Th3o4oR/Maggy/Maggy.kicad_pcb

## KiCad design Maggy.kicad_pcb (2026-10-21)

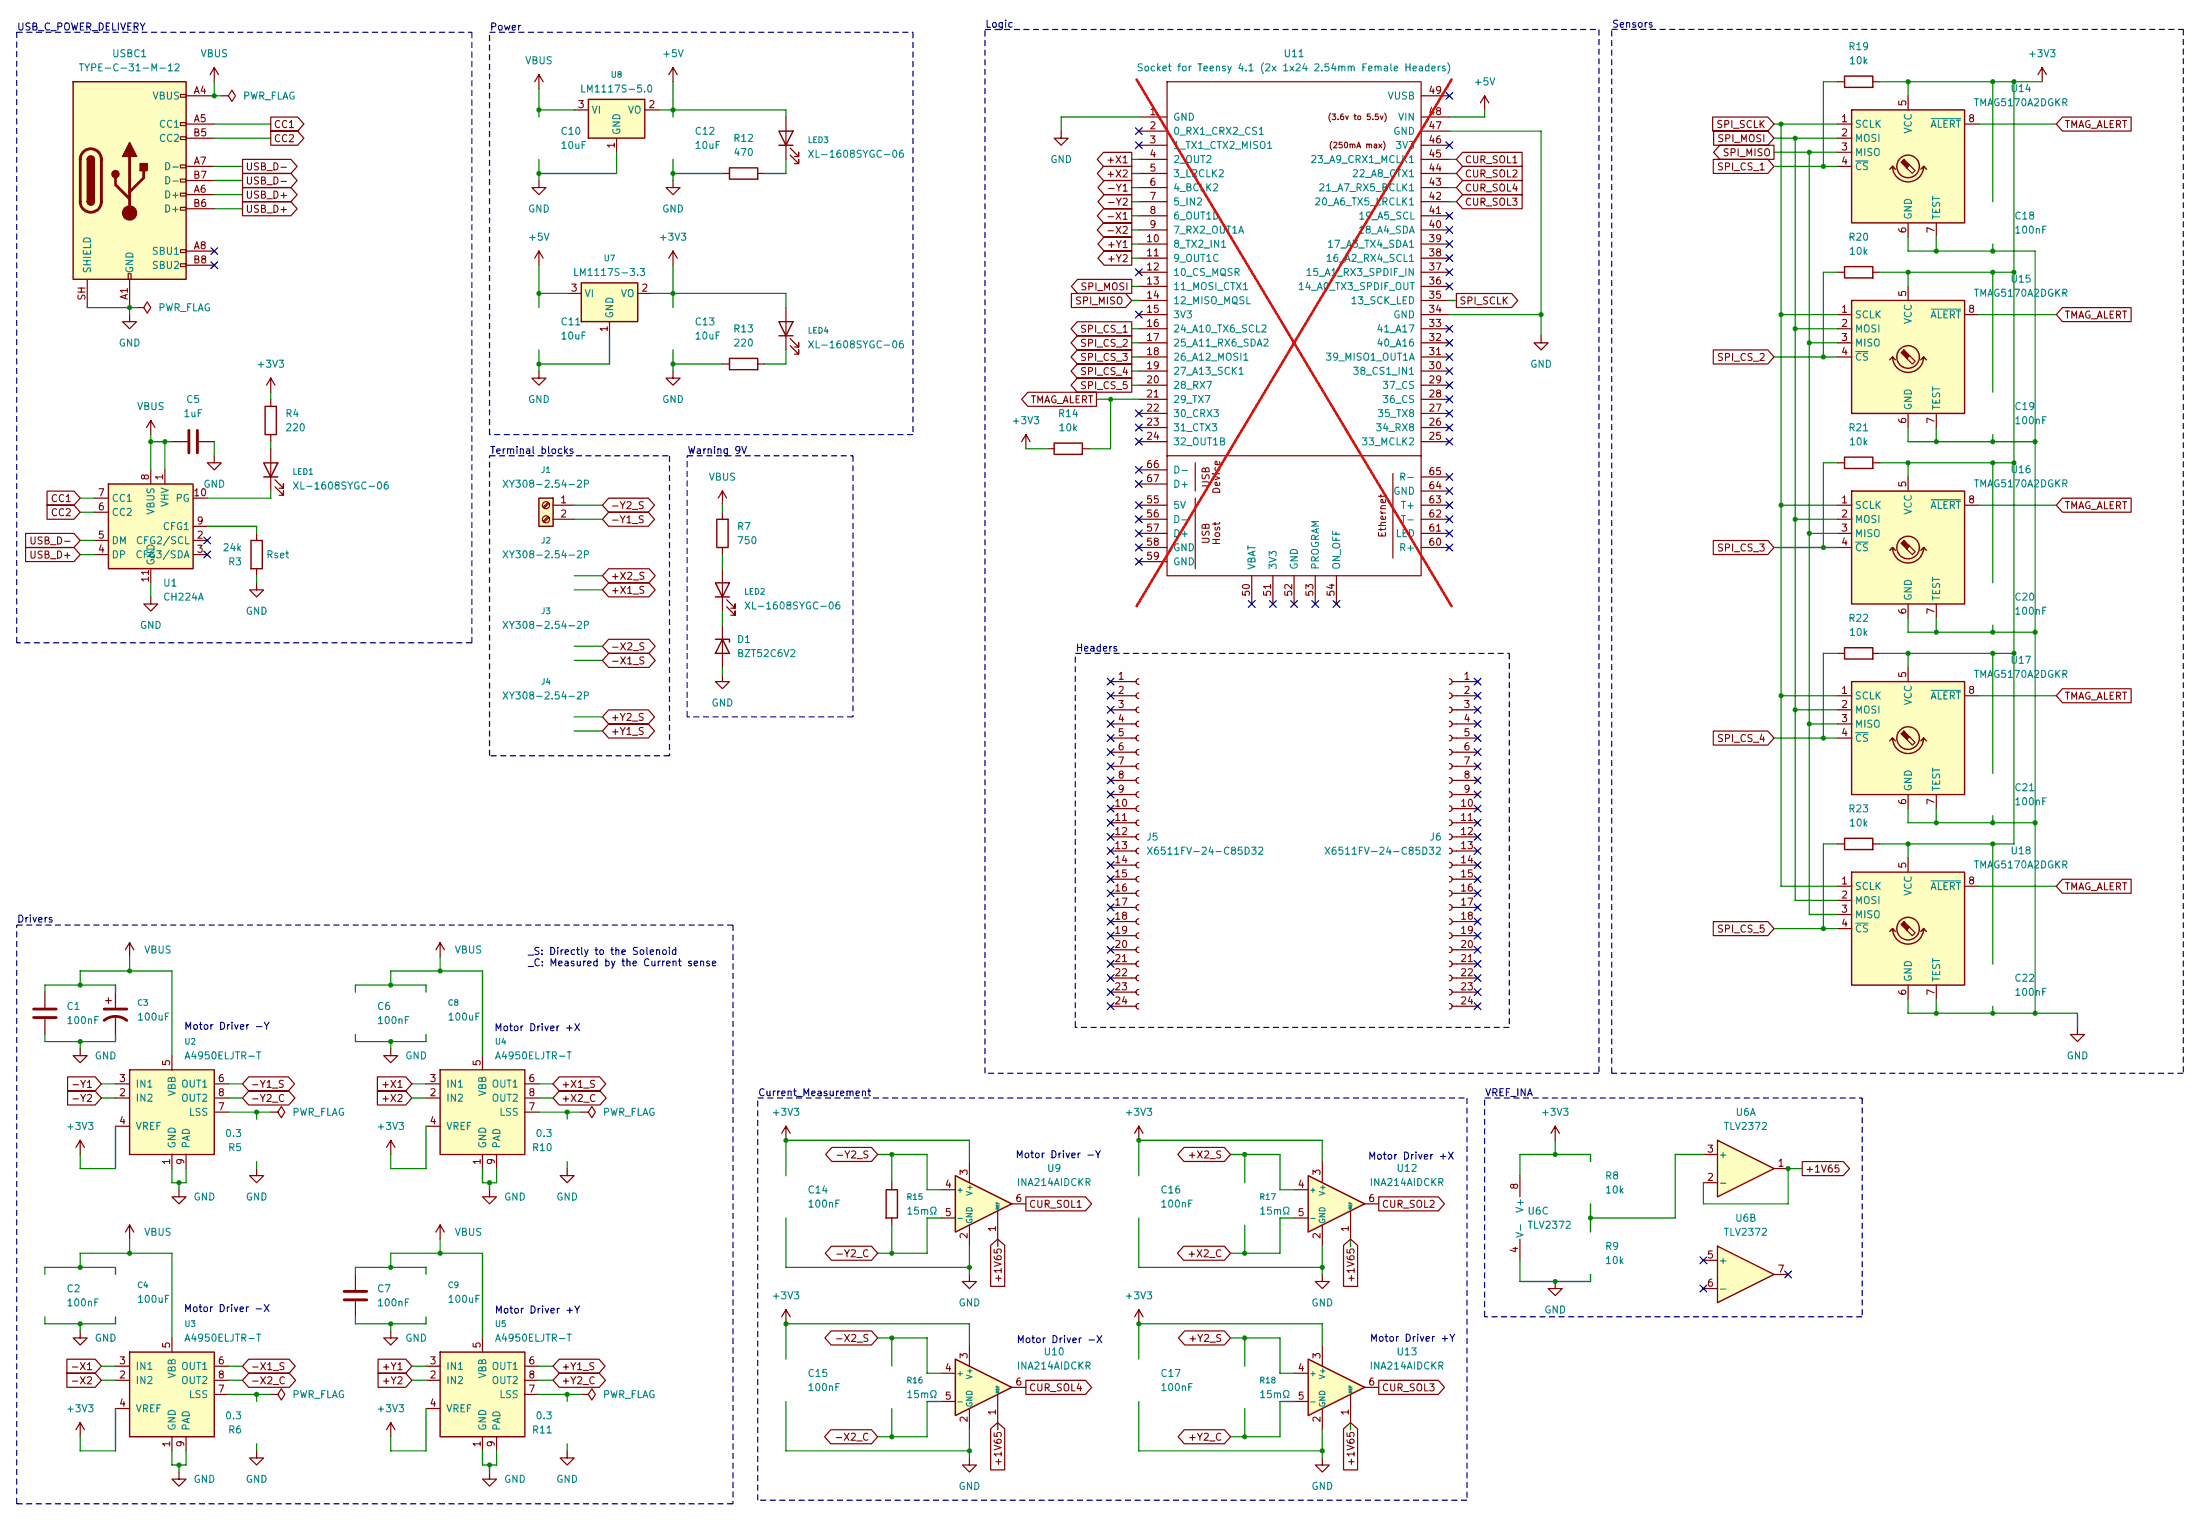
[picture p1: schematic Maggy.kicad_sch, Maggy Main Board]

Parts:
C1, C2, C6, C7, C14, C15, C16, C17, C18, C19, C20, C21, C22: 100nF; C_0603_1608Metric; LCSC C14663
C3, C4, C8, C9: 100uF; C_Elec_6.3x7.7; Manufacturer Part RST100UF35V009; LCSC Part Name 100uF ±20% 35V
C5: 1uF; C_0805_2012Metric; LCSC C28323
C10, C11, C12, C13: 10uF; C_0805_2012Metric; LCSC C15850
D1: BZT52C6V2; D_SOD-123; Manufacturer Part BZT52C6V2; LCSC Part Name BZT52C6V2
J1, J2, J3, J4: XY308-2.54-2P; TerminalBlock_Xinya_XY308-2.54-2P_1x02_P2.54mm_Horizontal; Manufacturer Part XY308-2.54-2P; LCSC Part Name 2.54mm 1x2P 排数:1 每排P数:2 直插
J5, J6: X6511FV-24-C85D32; PinHeader_1x24_P2.54mm_Vertical_NO_PADS; Manufacturer Part X6511FV-24-C85D32; LCSC C2883741
LED1: XL-1608SYGC-06; LED_0603_1608Metric; Manufacturer Part XL-1608SYGC-06; LCSC C965805
LED2, LED3, LED4: XL-1608SYGC-06; LED_0603_1608Metric; Manufacturer Part XL-1608SYGC-06; LCSC Part Name XL-1608SYGC-06
R3: 24k; R_0805_2012Metric; LCSC C17575
R4, R13: 220; R_0805_2012Metric; LCSC C17557
R5, R6, R10, R11: 0.3; R_1206_3216Metric; LCSC C59882
R7: 750; R_0805_2012Metric; LCSC C17818
R8, R9, R14, R19, R20, R21, R22, R23: 10k; R_0805_2012Metric; LCSC C17414
R12: 470; R_0805_2012Metric; LCSC C17710
R15, R16, R17, R18: 15mΩ; R_1206_3216Metric; Manufacturer Part 1206W3F150MT5E; LCSC Part Name RES 15mΩ ±1% 333mW 1206
U1: CH224A; SSOP-10-1EP_3.9x4.9mm_P1mm_EP2.1x3.3mm_ThermalVias; LCSC C42459160
U2, U3, U4, U5: A4950ELJTR-T; SOIC-8-1EP_3.9x4.9mm_P1.27mm_EP2.41x3.3mm_ThermalVias; Manufacturer Part A4950ELJTR-T; LCSC Part Name A4950ELJTR-T
U6: TLV2372; SOIC-8_3.9x4.9mm_P1.27mm; Manufacturer Part TLV2372IDR; LCSC Part Name TLV2372IDR
U7: LM1117S-3.3; SOT-223-3_TabPin2; Manufacturer Part LM1117S-3.3; LCSC Part Name 输入12V 输出3.3V 1A
U8: LM1117S-5.0; SOT-223-3_TabPin2; Manufacturer Part LM1117S-5.0; LCSC Part Name 输入12V 输出5V 1A
U9, U10, U12, U13: INA214AIDCKR; SOT-363_SC-70-6; Manufacturer Part INA214AIDCKR; LCSC Part Name INA214AIDCKR
U11: Socket for Teensy 4.1 (2x 1x24 2.54mm Female Head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; Teensy41_Socket_Only; not fitted
U14, U15, U16, U17, U18: TMAG5170A2DGKR; TMAG5170_Origin_Shifted_VSSOP-8_3x3mm_P0.65mm; LCSC C3716101
USBC1: TYPE-C-31-M-12; USB_C_Receptacle_HRO_TYPE-C-31-M-12; LCSC C165948

Connections:
+1V65: U6.1, U6.2 (-), U9.1 (REF), U10.1 (REF), U12.1 (REF), U13.1 (REF); also elsewhere on the board
+3V3: C13.2, C14.1, C15.1, C16.1, C17.1, C18.1, C19.1, C20.1, C21.1, C22.1, LED4.2 (A), R4.2, R8.2, R14.1, R19.2, R20.2, R21.2, R22.2, R23.2, U2.4 (VREF), U3.4 (VREF), U4.4 (VREF), U5.4 (VREF), U6.8 (V+), U7.2 (VO), U9.3 (V+), U10.3 (V+), U12.3 (V+), U13.3 (V+), U14.5 (VCC), U15.5 (VCC), U16.5 (VCC), U17.5 (VCC), U18.5 (VCC); also elsewhere on the board
+5V: C11.2, C12.2, LED3.2 (A), U7.3 (VI), U8.2 (VO), U11.48 (VIN); also elsewhere on the board
+X1: U4.3 (IN1), U11.4 (2_OUT2)
+X1_S: J2.2, U4.6 (OUT1)
+X2: U4.2 (IN2), U11.5 (3_LRCLK2)
+X2_C: R17.2, U4.8 (OUT2), U12.5 (-)
+X2_S: J2.1, R17.1, U12.4 (+)
+Y1: U5.3 (IN1), U11.10 (8_TX2_IN1)
+Y1_S: J4.2, U5.6 (OUT1)
+Y2: U5.2 (IN2), U11.11 (9_OUT1C)
+Y2_C: R18.2, U5.8 (OUT2), U13.5 (-)
+Y2_S: J4.1, R18.1, U13.4 (+)
-X1: U3.3 (IN1), U11.8 (6_OUT1D)
-X1_S: J3.2, U3.6 (OUT1)
-X2: U3.2 (IN2), U11.9 (7_RX2_OUT1A)
-X2_C: R16.2, U3.8 (OUT2), U10.5 (-)
-X2_S: J3.1, R16.1, U10.4 (+)
-Y1: U2.3 (IN1), U11.6 (4_BCLK2)
-Y1_S: J1.2, U2.6 (OUT1)
-Y2: U2.2 (IN2), U11.7 (5_IN2)
-Y2_C: R15.2, U2.8 (OUT2), U9.5 (-)
-Y2_S: J1.1, R15.1, U9.4 (+)
CC1: U1.7 (CC1), USBC1.A5 (CC1)
CC2: U1.6 (CC2), USBC1.B5 (CC2)
CUR_SOL1: U9.6, U11.45 (23_A9_CRX1_MCLK1)
CUR_SOL2: U11.44 (22_A8_CTX1), U12.6
CUR_SOL3: U11.42 (20_A6_TX5_LRCLK1), U13.6
CUR_SOL4: U10.6, U11.43 (21_A7_RX5_BCLK1)
GND: C1.1, C2.1, C3.2, C4.2, C5.1, C6.1, C7.1, C8.2, C9.2, C10.1, C11.1, C12.1, C13.1, C14.2, C15.2, C16.2, C17.2, C18.2, C19.2, C20.2, C21.2, C22.2, D1.2 (A), R3.2, R5.1, R6.1, R9.1, R10.1, R11.1, R12.1, R13.1, U1.11 (GND), U2.1 (GND), U2.9 (PAD), U3.1 (GND), U3.9 (PAD), U4.1 (GND), U4.9 (PAD), U5.1 (GND), U5.9 (PAD), U6.4 (V-), U7.1 (GND), U8.1 (GND), U9.2 (GND), U10.2 (GND), U11.1 (GND), U11.34 (GND), U11.47 (GND), U12.2 (GND), U13.2 (GND), U14.6 (GND), U14.7 (TEST), U15.6 (GND), U15.7 (TEST), U16.6 (GND), U16.7 (TEST), U17.6 (GND), U17.7 (TEST), U18.6 (GND), U18.7 (TEST), USBC1.A1 (GND), USBC1.A12 (GND), USBC1.B1 (GND), USBC1.B12 (GND), USBC1.SH (SHIELD)
unnamed: D1.1 (K), LED2.1 (K)
unnamed: LED1.2 (A), R4.1
unnamed: LED1.1 (K), U1.10 (PG)
unnamed: LED2.2 (A), R7.1
unnamed: LED3.1 (K), R12.2
unnamed: LED4.1 (K), R13.2
unnamed: R3.1, U1.9 (CFG1)
unnamed: R5.2, U2.7 (LSS)
unnamed: R6.2, U3.7 (LSS)
unnamed: R10.2, U4.7 (LSS)
unnamed: R11.2, U5.7 (LSS)
unnamed: R8.1, R9.2, U6.3 (+)
SPI_CS_1: R19.1, U11.16 (24_A10_TX6_SCL2), U14.4 (~CS)
SPI_CS_2: R20.1, U11.17 (25_A11_RX6_SDA2), U15.4 (~CS)
SPI_CS_3: R21.1, U11.18 (26_A12_MOSI1), U16.4 (~CS)
SPI_CS_4: R22.1, U11.19 (27_A13_SCK1), U17.4 (~CS)
SPI_CS_5: R23.1, U11.20 (28_RX7), U18.4 (~CS)
SPI_MISO: U11.14 (12_MISO_MQSL), U14.3 (MISO), U15.3 (MISO), U16.3 (MISO), U17.3 (MISO), U18.3 (MISO); also elsewhere on the board
SPI_MOSI: U11.13 (11_MOSI_CTX1), U14.2 (MOSI), U15.2 (MOSI), U16.2 (MOSI), U17.2 (MOSI), U18.2 (MOSI); also elsewhere on the board
SPI_SCLK: U11.35 (13_SCK_LED), U14.1 (SCLK), U15.1 (SCLK), U16.1 (SCLK), U17.1 (SCLK), U18.1 (SCLK); also elsewhere on the board
TMAG_ALERT: R14.2, U11.21 (29_TX7), U14.8 (~ALERT), U15.8 (~ALERT), U16.8 (~ALERT), U17.8 (~ALERT), U18.8 (~ALERT)
USB_D+: U1.4 (DP), USBC1.A6 (D+), USBC1.B6 (D+)
USB_D-: U1.5 (DM), USBC1.A7 (D-), USBC1.B7 (D-)
VBUS: C1.2, C2.2, C3.1, C4.1, C5.2, C6.2, C7.2, C8.1, C9.1, C10.2, R7.2, U1.1 (VHV), U1.8 (VBUS), U2.5 (VBB), U3.5 (VBB), U4.5 (VBB), U5.5 (VBB), U8.3 (VI), USBC1.A4 (VBUS), USBC1.A9 (VBUS), USBC1.B4 (VBUS), USBC1.B9 (VBUS); also elsewhere on the board

Notes on the sheet:
Terminal blocks
Motor Driver +X
USB_C_POWER_DELIVERY
Warning 9V
Motor Driver -X
Sensors
Motor Driver +Y
Headers
Logic
Motor Driver -Y
VREF_INA
Power
Current_Measurement
_S: Directly to the Solenoid _C: Measured by the Current sense
Drivers

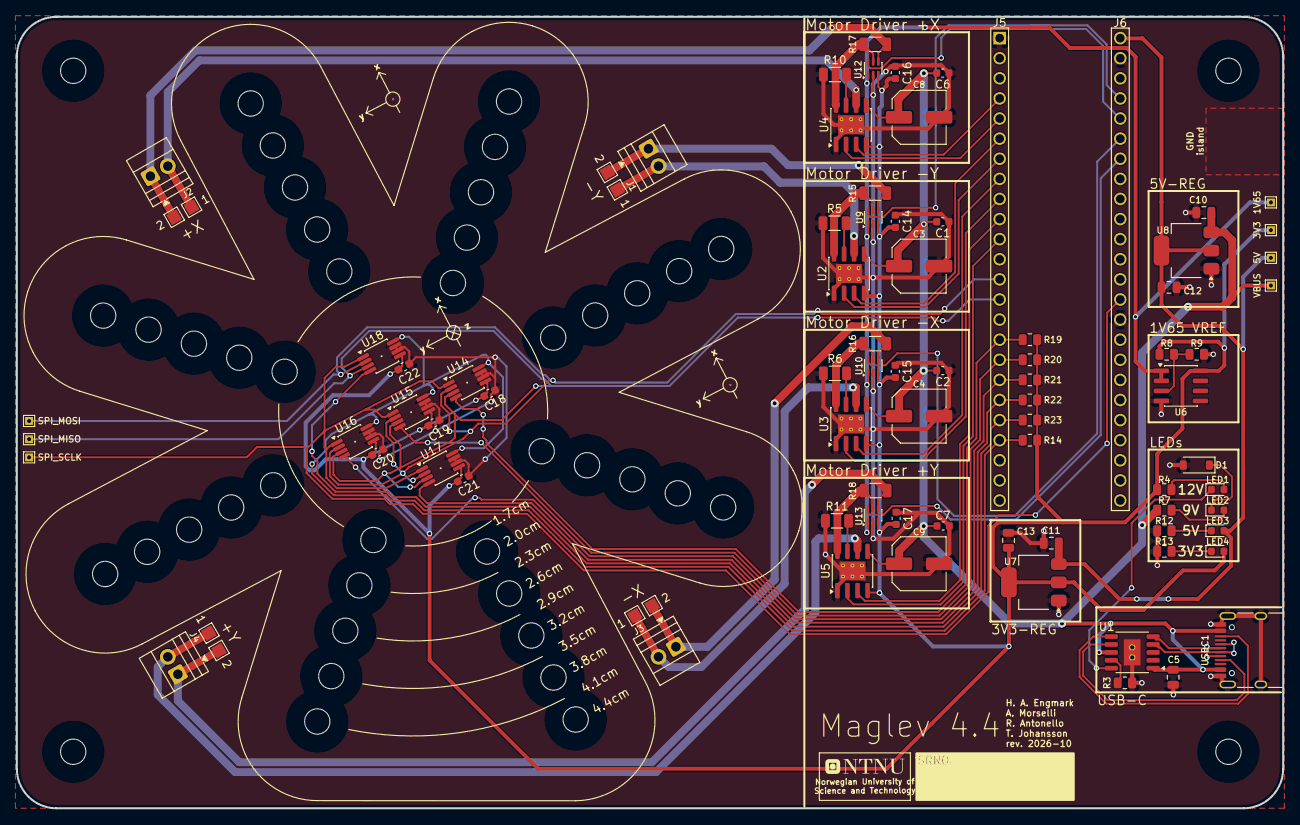
[picture p2: board Maggy.kicad_pcb from above]

Board: 2 copper layers, 160.0 x 100.0 mm, 80 parts (0 on the bottom side), 54 nets.

Other parts of the board:
1V65, 3V3, 5V: TestPoint_THTPad_1.0x1.0mm_Drill0.5mm
SPI_MISO: TestPoint_THTPad_1.0x1.0mm_Drill0.5mm
SPI_MOSI: TestPoint_THTPad_1.0x1.0mm_Drill0.5mm
SPI_SCLK: TestPoint_THTPad_1.0x1.0mm_Drill0.5mm
VBUS: TestPoint_THTPad_1.0x1.0mm_Drill0.5mm

Their connections:
+1V65: 1V65.1; also elsewhere on the board
+3V3: 3V3.1; also elsewhere on the board
+5V: 5V.1; also elsewhere on the board
SPI_MISO: SPI_MISO.1; also elsewhere on the board
SPI_MOSI: SPI_MOSI.1; also elsewhere on the board
SPI_SCLK: SPI_SCLK.1; also elsewhere on the board
VBUS: VBUS.1; also elsewhere on the board
