Th3o4oR/Maggy/ProPrj_Maggy 4.1_2025-02-07.kicad_pcb

## KiCad design ProPrj_Maggy 4.1_2025-02-07.kicad_pcb (2026-09-25)

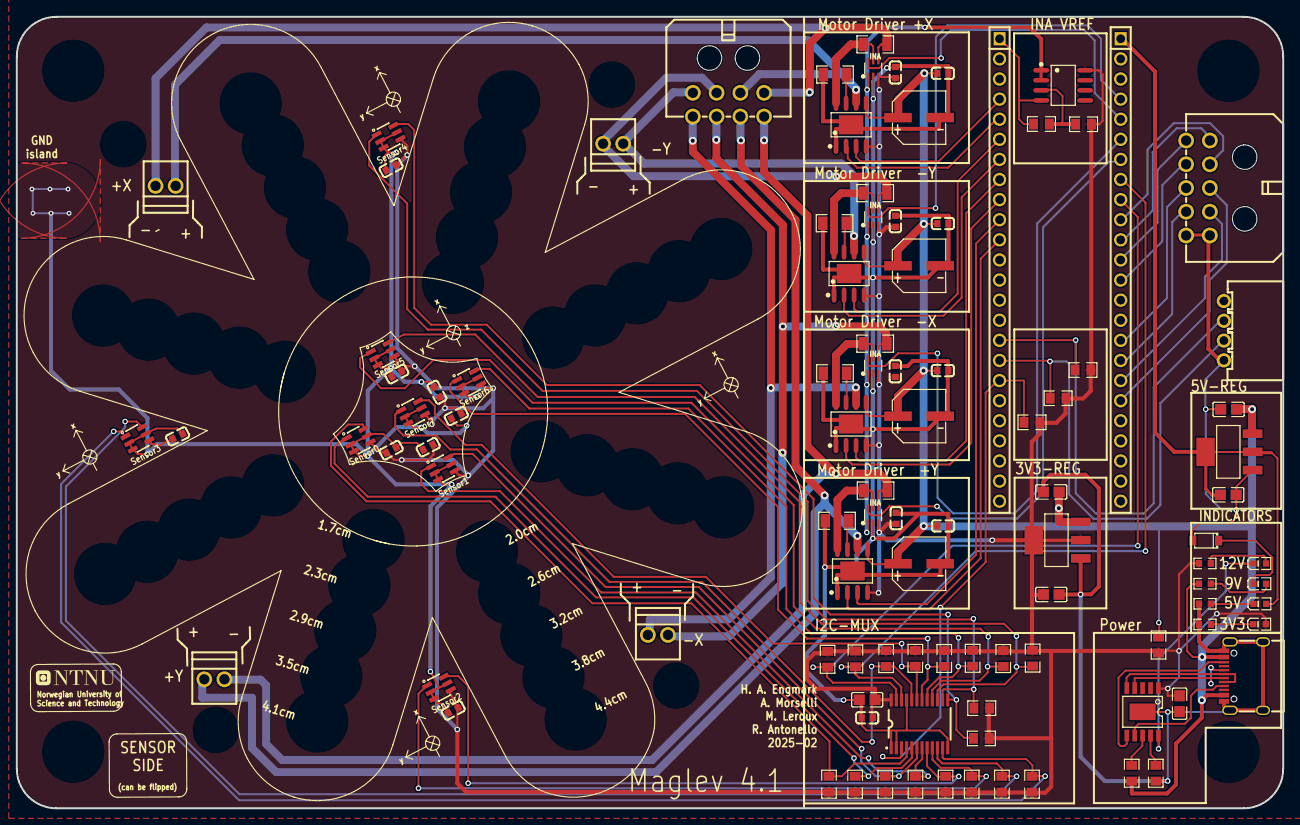
[picture p3: board ProPrj_Maggy 4.1_2025-02-07.kicad_pcb from above]

Board: 2 copper layers, 160.0 x 100.0 mm, 101 parts (0 on the bottom side), 75 nets.

Parts:
C1, C2, C3, C4, C6, C27: C0805
C5, C7, C8, C9, C10, C11, C12, C13, C14, C15, C17, C19, C21, C23, C24, C25, C26: C0603
C16, C18, C20, C22: CAP-SMD_BD6.3-L6.6-W6.6-LS7.2-FD
CN1: CONN-TH_43045-1000
CN2: CONN-TH_0430450800
LED1, LED2, LED3, LED4: LED0603-RD_GREEN
R1, R2, R6, R7, R8, R9, R10, R11, R12, R13, R14, R15, R16, R17, R18, R19, R20, R21, R26, R27, R29, R32, R33, R34, R39, R40: R0805
R3, R4, R5, R28: R0603
R22, R23, R24, R25, R35, R36, R37, R38: R1206
U1, U2: SOT-223-3_L6.5-W3.4-P2.30-LS7.0-BR
U3: ESSOP-10_L4.9-W3.9-P1.0-LS6.0-TL-EP
U4, U5: HDR-TH_24P-P2.54-V-F
U6: CONN-TH_XH2.54-4AW
U7: TSSOP-24_L7.8-W4.4-P0.65-LS6.4-BL
U10, U11, U12, U13, U14, U15, U16, U17: SOP-6_L3.0-W1.5-P0.95-LS2.5-BR
U20, U21, U22, U23: SOIC-8_L4.9-W3.9-P1.27-LS6.0-BL-EP
U27: SOD-123_L2.7-W1.6-LS3.7-RD
U30, U31, U32, U33: SC-70-6_L2.2-W1.3-P0.65-LS2.2-BR
U40: SOIC-8_L4.9-W3.9-P1.27-LS6.0-BL
U50, U51, U52, U53: CONN-TH_XY308-2.54-2P
USBC1: USB-C_SMD-TYPE-C-31-M-12

Connections:
1V65: U30.1, U31.1, U32.1, U33.1, U40.1, U40.2
1_1: CN2.1, U20.6, U50.1
1_21: CN2.2, R35.2, U30.4, U50.2
1_22: R35.1, U20.8, U30.5
2_1: CN2.3, U21.6, U51.1
2_21: CN2.4, R36.2, U31.4, U51.2
2_22: R36.1, U21.8, U31.5
3V3: C4.1, C5.1, C6.2, C7.1, C8.1, C9.1, C10.1, C11.1, C12.1, C13.1, C14.1, C23.2, C24.2, C25.2, C26.2, C27.1, LED1.2, R1.2, R2.2, R6.2, R7.2, R8.2, R9.2, R10.2, R11.2, R12.2, R13.2, R14.2, R15.2, R16.2, R17.2, R18.2, R19.2, R20.2, R21.2, R27.1, R28.2, R32.1, R33.1, R34.1, R39.2, U2.2, U2.4, U3.1, U6.1, U7.24, U10.4, U11.4, U12.4, U13.4, U14.4, U15.4, U16.4, U17.4, U20.4, U21.4, U22.4, U23.4, U30.3, U31.3, U32.3, U33.3, U40.8
3_1: CN2.7, U23.6, U53.1
3_21: CN2.8, R38.2, U33.4, U53.2
3_22: R38.1, U23.8, U33.5
4_1: CN2.5, U22.6, U52.1
4_21: CN2.6, R37.2, U32.4, U52.2
4_22: R37.1, U22.8, U32.5
$1N3748: R22.2, U20.7
$1N3820: LED2.1, R4.2
$1N3821: LED1.1, R3.2
$1N8157: R26.1, U3.9
$1N8202: R29.1, U3.8
$1N8651: R23.2, U21.7
$1N8936: R24.2, U22.7
$1N9221: R25.2, U23.7
$1N10392: LED4.1, U3.10
$1N10465: LED4.2, R28.1
$1N10718: LED3.1, U27.1
$1N10720: LED3.2, R5.1
$1N18521: R39.1, R40.2, U40.3
+5V: C2.1, LED2.2, U1.2, U1.4, U5.1
CC1: U3.7, USBC1.A5
CC2: U3.6, USBC1.B5
CUR_SOL1: U5.4, U30.6
CUR_SOL2: U5.5, U31.6
CUR_SOL3: U5.7, U33.6
CUR_SOL4: U5.6, U32.6
DM: U3.5, USBC1.A7, USBC1.B7
DP: U3.4, USBC1.A6, USBC1.B6
GND: C1.2, C2.2, C3.2, C4.2, C5.2, C6.1, C7.2, C8.2, C9.2, C10.2, C11.2, C12.2, C13.2, C14.2, C15.2, C16.2, C17.2, C18.2, C19.2, C20.2, C21.2, C22.2, C23.1, C24.1, C25.1, C26.1, C27.2, CN1.5, CN1.10, R3.1, R4.1, R22.1, R23.1, R24.1, R25.1, R26.2, R40.1, U1.1, U2.1, U3.11, U4.1, U5.2, U5.15, U6.4, U7.1, U7.2, U7.12, U7.21, U10.2, U10.3, U10.5, U11.2, U11.3, U11.5, U12.2, U12.3, U12.5, U13.2, U13.3, U13.5, U14.2, U14.3, U14.5, U15.2, U15.3, U15.5, U16.2, U16.3, U16.5, U17.2, U17.3, U17.5, U20.1, U20.9, U21.1, U21.9, U22.1, U22.9, U23.1, U23.9, U27.2, U30.2, U31.2, U32.2, U33.2, U40.4, USBC1.0, USBC1.1, USBC1.2, USBC1.3, USBC1.A1, USBC1.A12, USBC1.B1, USBC1.B12
HB_0A: U4.6, U20.3
HB_0B: U4.7, U20.2
HB_1A: U4.4, U21.3
HB_1B: U4.5, U21.2
HB_2A: U4.10, U23.3
HB_2B: U4.11, U23.2
HB_3A: U4.8, U22.3
HB_3B: U4.9, U22.2
I2C_RST: R32.2, U4.18, U7.3
I2C_SCL: R2.1, U5.8, U7.22
I2C_SCL2: R34.2, U4.16, U6.2
I2C_SDA: R1.1, U5.9, U7.23
I2C_SDA2: R33.2, U4.17, U6.3
SCL0: R7.1, U7.5, U10.1
SCL1: R9.1, U7.7, U11.1
SCL2: R11.1, U7.9, U12.1
SCL3: R13.1, U7.11, U13.1
SCL4: R15.1, U7.14, U14.1
SCL5: R17.1, U7.16, U15.1
SCL6: R19.1, U7.18, U16.1
SCL7: R21.1, U7.20, U17.1
SDA0: R6.1, U7.4, U10.6
SDA1: R8.1, U7.6, U11.6
SDA2: R10.1, U7.8, U12.6
SDA3: R12.1, U7.10, U13.6
SDA4: R14.1, U7.13, U14.6
SDA5: R16.1, U7.15, U15.6
SDA6: R18.1, U7.17, U16.6
SDA7: R20.1, U7.19, U17.6
UX_N_IN: CN1.9, U5.17
UX_N_OUT: CN1.1, U5.11
UX_P_IN: CN1.8, U5.16
UX_P_OUT: CN1.2, U5.10
UY_N_IN: CN1.3, U5.19
UY_N_OUT: CN1.7, U5.13
UY_P_IN: CN1.4, U5.18
UY_P_OUT: CN1.6, U5.12
VBUS: C1.1, C3.1, C15.1, C16.1, C17.1, C18.1, C19.1, C20.1, C21.1, C22.1, R5.2, R27.2, R29.2, U1.3, U2.3, U20.5, U21.5, U22.5, U23.5, USBC1.A4, USBC1.A9, USBC1.B4, USBC1.B9
