Th3o4oR/Maggy/(commit log)

2026-09-24 feat: initial commit
    [ProPrj_Maggy 4.1_2025-02-07.kicad_pcb, ProPrj_Maggy 4.1_2025-02-07.kicad_sch]
2026-09-25 feat: updated schematic with replacement from I2C sensors to SPI sensors
    [ProPrj_Maggy 4.1_2025-02-07.kicad_sch]
2026-09-25 chore: replace EasyEDA power symbols with KiCad power symbols
    [ProPrj_Maggy 4.1_2025-02-07.kicad_sch]
2026-09-25 chore: re-annotated entire schematic
    [ProPrj_Maggy 4.1_2025-02-07.kicad_sch]
2026-09-25 chore: auto-placed labels, replaced easyeda yellow-green LED with KiCad LED
    [ProPrj_Maggy 4.1_2025-02-07.kicad_sch]
2026-09-25 chore: replaced all yellow-green LEDs
    [ProPrj_Maggy 4.1_2025-02-07.kicad_sch]
2026-09-25 feat: added teensy 4.1 to schematic
    Added the Teensy 4.1 symbol to the libs/ directory, and replaced the old symbol in the schematic using two female headers with the new symbol, which gives correct pin directions, descriptions, etc.
    [ProPrj_Maggy 4.1_2025-02-07.kicad_pcb, ProPrj_Maggy 4.1_2025-02-07.kicad_sch]
2026-09-27 chore: replaced more easyeda components with KiCad counterparts
    Components: Some resistors, capacitors and terminal blocks
    [ProPrj_Maggy 4.1_2025-02-07.kicad_sch]
2026-09-29 chore: rename project to "Maggy"
    [Maggy.kicad_pcb, Maggy.kicad_sch]
2026-09-29 chore: replace EasyEDA CH224K custom symbol with KiCad native one
    [Maggy.kicad_sch]
2026-09-29 chore: replace EasyEDA custom USB-C symbol with KiCad native one
    [Maggy.kicad_sch]
2026-09-29 chore: replace EasyEDA custom connectors with KiCad native ones
    [Maggy.kicad_sch]
2026-09-29 chore: replace EasyEDA motor drivers with KiCad native ones
    [Maggy.kicad_sch]
2026-09-29 fix: update hall-effect sensors MISO pin type to tri-state
    Since two output pin types cannot be connected together (due to risks of shorts if one pin attempts to drive a signal high, while the other drives it low), MISO pins should actually use a tri-state function. This represents how the dynamics actually work, where the sensors disconnects its MISO pin as long as its CS line is not active.
    [Maggy.kicad_sch]
2026-09-29 chore: replace EasyEDA power regulator symbols with KiCad native ones
    [Maggy.kicad_sch]
2026-09-29 chore: replace EasyEDA op-amp symbol with KiCad native three-part one
    Replaced op-amp symbol for the part of the schematic generating the 1.65V reference for current sensing with a native KiCad symbol for the same op-amp. The new symbol is split into three parts instead of being a single block.
    [Maggy.kicad_sch]
2026-09-29 chore: add footprint to new op-amp symbols
    [Maggy.kicad_sch]
2026-09-29 chore: replace EasyEDA screw terminals with KiCad native ones
    [Maggy.kicad_sch]
2026-09-29 chore: update references for screw terminals to match common convention
    The naming for references for the screw terminals were prefixed with U-, which is usually reserved for integrated circuits. They have been replaced with J- references.
    [Maggy.kicad_sch]
2026-09-29 chore: replace EasyEDA zener diode with a KiCad native one
    [Maggy.kicad_sch]
2026-09-29 chore: replace EasyEDA current measurement op-amps with KiCad native ones
    [Maggy.kicad_sch]
2026-09-29 chore: re-annotated schematic
    [Maggy.kicad_sch]
2026-09-29 fix: ERC issue related to power direction for LSS pin at drivers
    [Maggy.kicad_sch]
2026-09-30 fix: update Teensy library symbol pins 46 and 47 with correct function
    The Teensy symbol's pins were labelled incorrectly:
    - Pin 46 (3v3) labelled as "Output", updated to "Power output"
    - Pin 47 (GND) labelled as "Output", updated to "Power input"
    This helps satisfy the ERC, which correctly flagged that pins of type "Output" and "Power output" (other components on the ground net) were incompatible with each other.
    [Maggy.kicad_sch]
2026-09-30 fix: update SPI-sensors' power source from VCC to 3v3
    [Maggy.kicad_sch]
2026-09-30 fix!: resolve short between VBUS and GND near motor drivers
    During the migration from EasyEDA, a mistake was introduced shorting VBUS to GND near the power supply for each motor driver. This was caught by the ERC, and this commit removes the shorted connection.
    [Maggy.kicad_sch]
2026-09-30 chore: replace all EasyEDA capacitor symbols with KiCad native ones
    [Maggy.kicad_sch]
2026-09-30 chore: replace all EasyEDA polarized capacitor symbols with KiCad native ones
    [Maggy.kicad_sch]
2026-09-30 chore: add power flag to USB-C GND connection
    This indicates to KiCad that the external, incoming GND connection is driven, preventing ERC warnings and errors about "Power inputs" not being connected to any "Power outputs", etc.
    Especially annoying when wiring decoupling capacitors
    [Maggy.kicad_sch]
2026-09-30 chore: update footprints for solenoid terminal blocks
    They were referencing a non-existing footprint lost during the EasyEDA import, updated to a KiCad native one
    [Maggy.kicad_sch]
2026-09-30 chore: replace EasyEDA GND symbol for SPI sensors
    [Maggy.kicad_sch]
2026-09-30 chore: replace current sensing resistors' symbols from EasyEDA to KiCad ones
    [Maggy.kicad_sch]
2026-09-30 chore: add teensy headers to schematic
    Added two header rows to the schematic, so they are included on the BOM. These are not to be used for routing, the Teensy is so the pin names and functions are present, but this way the headers should be auto-placed by the manufacturer.
    Marked the Teensy as DNP.
    [Maggy.kicad_sch]
2026-10-01 fix: motor driver component references
    [Maggy.kicad_pcb, Maggy.kicad_sch]
2026-10-01 chore: left-align and move attribution text
    [Maggy.kicad_pcb]
2026-10-01 fix: current measurement component references
    [Maggy.kicad_pcb, Maggy.kicad_sch]
2026-10-01 fix: voltage regulator component references
    [Maggy.kicad_pcb]
2026-10-01 fix: current measurement reference voltage component references
    [Maggy.kicad_pcb]
2026-10-01 fix: power delivery component references
    [Maggy.kicad_pcb]
2026-10-01 fix: 9V led component references
    [Maggy.kicad_pcb]
2026-10-01 fix: 12V led indicator component references
    [Maggy.kicad_pcb]
2026-10-01 fix: terminal blocks component references
    [Maggy.kicad_pcb]
2026-10-01 chore: remove I2C mux components from PCB
    [Maggy.kicad_pcb]
2026-10-01 chore: remove unused I2C components
    [Maggy.kicad_pcb]
2026-10-01 chore: remove teensy headers
    [Maggy.kicad_pcb]
2026-10-01 chore: update footprints for connectors
    [Maggy.kicad_pcb]
2026-10-01 chore: remove I2C external connector
    [Maggy.kicad_pcb]
2026-10-01 chore: add teensy footprint to schematic
    [Maggy.kicad_sch]
2026-10-01 chore: replaced footprints for linear regulators
    [Maggy.kicad_pcb, Maggy.kicad_sch]
2026-10-01 chore: updated footprint for VREF op-amp
    [Maggy.kicad_pcb, Maggy.kicad_sch]
2026-10-01 chore: updated footprint for USB-C connector
    [Maggy.kicad_pcb]
2026-10-01 chore: updated footprint for USB-C power delivery chip
    [Maggy.kicad_pcb]
2026-10-01 chore: updated footprint for motor driver chips
    [Maggy.kicad_pcb]
2026-10-01 chore: updated footprint for terminal blocks
    [Maggy.kicad_pcb]
2026-10-02 chore: update footprints for other components, ran "update PCB from schematic"
    This also replaced the silkscreen outlines for things like resistors
    - Deleted "INA" text, which was already hidden underneath each current sensing op-amp
    [Maggy.kicad_pcb]
2026-10-02 chore: removed unused I2C mux traces
    [Maggy.kicad_pcb]
2026-10-02 chore: update reference text height globally
    Updated all silkscreen reference text elements to have a minimum text height of 0.8mm to satisfy the DRC
    [Maggy.kicad_pcb]
2026-10-02 chore: updated silkscreen text attributes
    [Maggy.kicad_pcb]
2026-10-02 chore: removed old sensor routing
    [Maggy.kicad_pcb]
2026-10-02 fix: motor drivers mounted 180 degrees incorrect
    [Maggy.kicad_pcb]
2026-10-02 fix: flip capacitors to match schematic direction
    Some capacitors were flipped the wrong way around compared to the schematic,
    causing DRC errors complaining about shorts. Shouldn't really matter? Since
    the capacitors are bi-directional.
    [Maggy.kicad_pcb]
2026-10-02 chore: remove incorrectly labelled nets, update tracks missing nets
    [Maggy.kicad_pcb, Maggy.kicad_sch]
2026-10-02 chore: add teensy (socket) footprint to PCB
    [Maggy.kicad_pcb]
2026-10-04 fix: routing for the motor drivers
    Fixed routing for the motor drivers, clearing any DRC violations while at it
    [Maggy.kicad_pcb, Maggy.kicad_sch]
2026-10-04 fix: fixed routing for USB-C and power management
    [Maggy.kicad_pcb]
2026-10-04 fix: routing for CN2
    [Maggy.kicad_pcb]
2026-10-04 fix: routing for CN1
    [Maggy.kicad_pcb]
2026-10-04 fix: routing for terminal blocks
    [Maggy.kicad_pcb]
2026-10-04 fix: disconnected CUR_SOL_3 trace
    [Maggy.kicad_pcb]
2026-10-04 fix: missing connection between 4_1 and CN1
    [Maggy.kicad_pcb]
2026-10-04 fix: added proper mounting holes for the four corners
    [Maggy.kicad_pcb]
2026-10-04 chore: added keepout zones around corner mounting holes
    [Maggy.kicad_pcb]
2026-10-04 chore: replaced center arcs with actual circles, ensured it is centered for future precise positioning
    [Maggy.kicad_pcb]
2026-10-04 feat: added mounting holes for solenoids
    [Maggy.kicad_pcb]
2026-10-04 feat: added mounting holes for permanent magnets
    [Maggy.kicad_pcb]
2026-10-05 chore: differential routing for USB-C connector
    [Maggy.kicad_pcb, Maggy.kicad_sch]
2026-10-07 feat: initial routing for SPI sensors
    - Added SPI sensors to the board. This included modifying the existing footprint in order to mark the sensing element's sensor on the package, which isn't in the exact center of the package. The updated footprint is included in the project's library file.
    - Routed decoupling caps to the sensors
    - Routed pull-up resistors to CS lines and ALERT line
    - First attempt at routing each sensor's 8 pins in a sensible manner
    [Maggy.kicad_pcb, Maggy.kicad_sch]
2026-10-07 chore: simplify mounting hole clearance
    Replaced keep-out zones around each mounting hole with a pad-clearance override native to the hole itself, preventing the need for the keep-out zone altogether
    [Maggy.kicad_pcb]
2026-10-07 chore: add custom rule to exclude mounting holes from DRC
    Because the mounting holes for the permanent magnets and solenoids have overlapping courtyards, they need to be exempt from the DRC check
    [Maggy.kicad_pcb]
2026-10-07 chore: update terminal block polarity silkscreen positioning
    [Maggy.kicad_pcb]
2026-10-10 chore: WIP fixing the ground islands
    KiCad doesn't play nice with the ground island apparently, so a hacky solution was implemented to sort of get it working. Two solder-mask zones were added in order to get the rounded corners correct, and a separate copper fill was added to the top layer because the top fill is connected to the 3v3 net, not ground.
    [Maggy.kicad_pcb]
2026-10-10 chore: move silkscreen items: name, attribution, logo, serial number
    Serial number was not a part of the silkscreen from before, but was added with this commit.
    [Maggy.kicad_pcb]
2026-10-10 chore: remove unused mounting holes near terminal blocks
    [Maggy.kicad_pcb]
2026-10-10 chore: repositioned terminal blocks in accordance with 4.3 version
    Added test pads to the terminal blocks' output, and oriented them (almost) parallel to the magnets (magnets are positioned about 27.8113 degrees positive direction relative to the vertical line in 45 degree increments, the terminal blocks are placed at exact 30 degree increments).
    [Maggy.kicad_pcb]
2026-10-10 fix: reduce board rules minium drill size from 0.3mm to 0.2mm
    This was causing several DRC errors because of the thermal vias underneath the motor drivers, which were modelled as 0.2mm holes in the KiCad library
2026-10-10 fix: missing connection between motor driver LSS pin and resistor
    [Maggy.kicad_pcb]
2026-10-10 fix: connect unconnected SPI_MOSI for one of the SPI sensors
    [Maggy.kicad_pcb]
2026-10-10 fix: clearance violation for VBUS trace near USB-C
    [Maggy.kicad_pcb]
2026-10-10 chore: remove "sensor side" silkscreen label
    [Maggy.kicad_pcb]
2026-10-10 chore: remove title and logo from back-side of PCB
    [Maggy.kicad_pcb]
2026-10-11 chore: exclude silkscreen overlap errors from DRC, convert central circle into four arcs
    The central circle was causing DRC errors because it was overlapping with the mounting holes for the permanent magnets. Replaced the central circle with four arcs instead, removing the overlapping region.
    [Maggy.kicad_pcb]
2026-10-11 chore: update silkscreen measuring magnet distance
    [Maggy.kicad_pcb]
2026-10-11 chore: exclude DRC error regarding overlapping silkscreen for SRNO.
2026-10-11 chore: remove CN1
    [Maggy.kicad_pcb]
2026-10-11 chore: remove CN2
    [Maggy.kicad_pcb]
2026-10-11 chore: move 5v regulator
    [Maggy.kicad_pcb]
2026-10-11 chore: move 1v65 regulator
    [Maggy.kicad_pcb]
2026-10-11 chore: move and reroute 3v3 regulator, usb-c power and usb-c controller
    [Maggy.kicad_pcb]
2026-10-11 fic: remove forgotten connector schematics
    [Maggy.kicad_sch]
2026-10-13 chore: attach floating 3v3 line
    [Maggy.kicad_pcb]
2026-10-13 chore: remove unused UX/UY flags from schematic
    [Maggy.kicad_sch]
2026-10-14 fix: update motor driver +Y footprint to include thermal vias
    Footprint was missing thermal vias, which the other drivers had included.
    [Maggy.kicad_pcb, Maggy.kicad_sch]
2026-10-14 chore: remove silkscreen text for unused Teensy pins from rear of PCB
    [Maggy.kicad_pcb]
2026-10-14 chore: update attributions
    [Maggy.kicad_pcb]
2026-10-14 chore: update fill zone regions
    [Maggy.kicad_pcb]
2026-10-14 chore: add 3D model for Teensy
    [Maggy.kicad_pcb]
2026-10-14 chore: add 3D model for motor drivers
    [Maggy.kicad_pcb]
2026-10-14 chore: add 3D model for terminal blocks
    [Maggy.kicad_pcb]
2026-10-14 chore: add 3D model for USB-C connector
    [Maggy.kicad_pcb]
2026-10-15 chore: replaced 3D model for Teensy with one with colours
    Source: https://github.com/XenGi/teensy.pretty/pull/17/commits
2026-10-15 fix: update LED resistor values
    LED resistors values were too low to comply with the stated limits in the
    datasheet. They draw too much continuous current, exceeding the 20mA.
    Updated resistor so current draw is limited to about 5-6mA.
    Also updated the LEDs themselves to ensure they all reference the same
    component and datasheet.
    [Maggy.kicad_pcb, Maggy.kicad_sch]
2026-10-15 refactor(power): cascade 3V3 regulator input from +5V rail instead of 12V VBUS
    - Connect LM1117-3.3 VIN to regulated +5V output rather than raw 12V VBUS.
    This matches the design from board version 4.3, and should provide improved
    LDO PSRR (power supply rejection ratio) to isolate 12V solenoid PWM
    switching noise from the +3V3 rail. The +3V3 rail is connected to things like
    the +1V65 current sense reference, and should be as stable as possible.
    [Maggy.kicad_pcb, Maggy.kicad_sch]
2026-10-15 doc: add documentation for resistor values driving the voltage negotiation
    [Maggy.kicad_sch]
2026-10-15 chore: remove link to missing EasyEDA footprint library
2026-10-15 chore: update 9V LED resistor
    [Maggy.kicad_pcb, Maggy.kicad_sch]
2026-10-15 chore: replace the top 3V3 with a GND plane
    Between revisions 4.2 and 4.3 this change was introduced in order to give more shielding to the I2C bus lines from the changing magnetic fields, so it has now been introduced here as well, even though the impact it will have on shielding the SPI bus lines is dubious.
    [Maggy.kicad_pcb]
2026-10-15 chore: simplify and move ground island
    [Maggy.kicad_pcb]
2026-10-15 chore: add test points for power, fix ground island so it is accessible on back as well
    [Maggy.kicad_pcb]
2026-10-15 chore: add test points for SPI bus lines
    [Maggy.kicad_pcb]
2026-10-15 chore: update net names and labels for solenoid currents
    The naming scheme for solenoid currents in 4.1 was both inconsistent and
    difficult to reason about, mixing between being 0-indexed and 1-indexed
    as well as using a numbering scheme rather than letters. The silkscreen
    on the board identifies the solenoids/terminal blocks by its magnetic
    field direction (X/Y) and its sign (+/-), so the solenoid currents are
    named accordingly, just like they were in 4.3.
    Old names compared to new ones:
    ```
    OLD NEW
    HB_1A -> 2_1 +X1 -> +X1_S
    HB_1B -> 2_22 +X2 -> +X2_C
    HB_0A -> 1_1 -Y1 -> -Y1_S
    HB_0B -> 1_22 -Y2 -> -Y2_C
    HB_3A -> 4_1 -X1 -> -X1_S
    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
    [Maggy.kicad_pcb, Maggy.kicad_sch]
2026-10-16 fix: outdated fields for current sense resistors
    Current sense resistors showed a value of 15millihoms, but linked to a component with a value of 10millihoms in several fields of the part's description. Updated all fields to point to the correct 15milliohm resistor.
    [Maggy.kicad_pcb, Maggy.kicad_sch]
2026-10-16 chore: cleaned up schematic to fit on A3 sheet
    [Maggy.kicad_sch]
2026-10-16 chore: update schematic title block
    [Maggy.kicad_sch]
2026-10-16 chore: add teensy headers to PCB for automatic placement
    [Maggy.kicad_pcb, Maggy.kicad_sch]
2026-10-16 chore: update all components with LCSC part numbers
    Added `jlcpcb` to gitignore, to ignore generated files like BOM, CPL and gerbers, as well as the database for the kicad-jlcpcb-tools plugin used for sourcing components
    [Maggy.kicad_pcb, Maggy.kicad_sch]
2026-10-18 feat: replace CH224K USB-C PD chip with newer CH224A version
    The old CH224K chip is no longer held in stock in LCSC/JLCPCB, and could therefore not be manufactured. The CH224A is a pin for pin replacement, with improved capabilities and fewer required external components.
    [Maggy.kicad_pcb, Maggy.kicad_sch]
2026-10-18 chore: update header rows footprint to match what JLCPCB expects
    [Maggy.kicad_pcb]
2026-10-18 chore: remove silkscreen tables for "Analog I/O" and "Solenoids pins"
    These connectors no longer exist on the board, so they don't make sense to keep.
    [Maggy.kicad_pcb]
2026-10-21 fix: corrected terminal blocks so they point toward the center
    The terminal blocks had been placed in a way so the attachments points were facing away from the center of the board. To correct this, the terminal blocks were rotated 180 degrees, and the schematic was updated to swap the attached nets accordingly.
    The PCB routing to the terminal blocks was already correct and correctly labelled, so it remains unchanged.
    [Maggy.kicad_pcb, Maggy.kicad_sch]
2026-10-21 fix: 3d model orientation and offset for teensy headers
    The 3D model for the teensy headers was not oriented correctly relative to their footprints, resulting in the headers jutting out at 90 degrees in the wrong spot. Updated the model orientation and offset so they align properly. Purely cosmetic.
    [Maggy.kicad_pcb]
